WB2CBA/PEBBLE-20m-HF-TRANSCEIVER/PEBBLEHF V2.7 40m BAND/PEBBLEHF V2.7 40m SOLDER SIDE LAYOUT.jpg

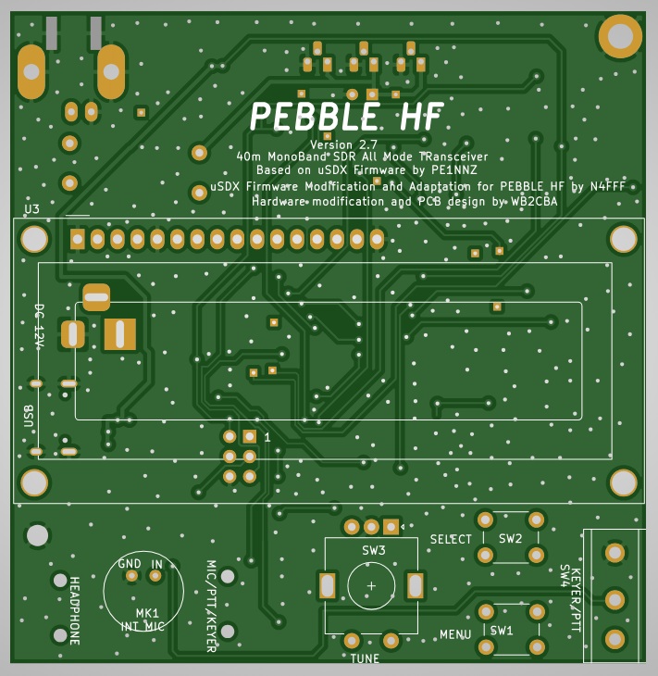
PEBBLEHF V2.7 40m BAND/PEBBLEHF V2.7 40m SOLDER SIDE LAYOUT.jpg
