WB2CBA/PEBBLE-20m-HF-TRANSCEIVER/README.md

# PEBBLE-HF-MONOBAND SDR HF TRANSCEIVER

https://pebblehf.com/
---------------------

PEBBLE HF is an open source project. Hardware details are in this github. I also included latest firmware under PEBBLEHF FIRMWARE directory for the sake of practical reaching to the latest version.

PEBBLE HF info and build manual plus Latest PEBBLE HF Firmware can be downloaded from this github link: https://github.com/mspiceland/usdx-pebblehf
-------------------------------------------------------------------------------------------------------------------------------------------
PEBBLE HF is a Monoband HF ALL MODE SDR TRANSCEIVER. Currently there is two band versions, 20m band and 40m band you can build with all the files and info posted in this github page.
-------------------------------------------------------
Pebble HF

Richard Hinsley/ VK2ARH put together a very detailed PEBBLEHF Build Manual for 40m PEBBLEHF. It can also be used for 20m PEBBLEHF Build as they are identical apart from operating frequencies. I added to this repository. 

Thank you Richard. This is a great help.

Mike, N4FFF designed a very nice 3D printed case for PEBBLEHF. Here is the link: https://hamradioduo.com/print-your-own-pebble-hf-case/

For anyone who is 3D print challenged like myself I put together a bolt on top and bottom PCB panels which are included as GERBER files in the fabrication 
files folders. It is not as elegant as 3D case but does the job to cover and protect the electronics. This cover is compatible with both V2.5 and V2.7 Pebblehf.



PEBBLE HF is based on USDX Micro Software Defined Transceiver Project with hardware and Firmware changes adapted to suit PEBBLE HF functions.

uSDX: micro Software Defined Transceiver Project Github Link.
https://github.com/threeme3/usdx

Anyone can build PEBBLE HF and program it with uSDX firmware or PEBBLE HF Specific Firmware. PEBBLE HF Hardware works with both options.

PEBBLE HF Transceiver can be ordered from www.jlcpcb.com using fabrication files in fabrication file folder.

Credits
-------
Pebble HF Project: Mike N4FFF - Firmware modifications and project maintenance

Original uSDX Project: The uSDX was originally announced in the QRPLabs Forum as a SSB modification for a QCX. The uSDX transmitter and receiver stage both running on a ATMEGA328P, including its multiband front-end and direct PA biasing/envelope-generation technique; its concept, circuit, code are a design by Guido (PE1NNZ); the software-based SSB transmit stage is a derivate of earlier experiments with a digital SSB generation technique on a Raspberry Pi.

Hardware Design: Barbaros Asuroglu (WB2CBA) - Pebble HF hardware design

Many thanks to all contributors to the open source uSDX project, without whose work the Pebble HF would not be possible.
