WB2CBA/PEBBLE-20m-HF-TRANSCEIVER/PEBBLEHF FIRMWARE/README.pdf

BOTH V1.08 firmware is same in functionality as V1.07 OFFICIAL PEBBLEHF FIRMWARE POSTED ON THIS LINK:
https://github.com/mspiceland/usdx-pebblehf
The only change in V1.08 firmware is the ability to select board band type before flashing the firmware.
There is no need to upgrade to V1.08 Firmware if you already have a V1.07 firmware installed on your PEBBLEHF.
