WB2CBA/PEBBLE-20m-HF-TRANSCEIVER/IMG_0782.jpeg

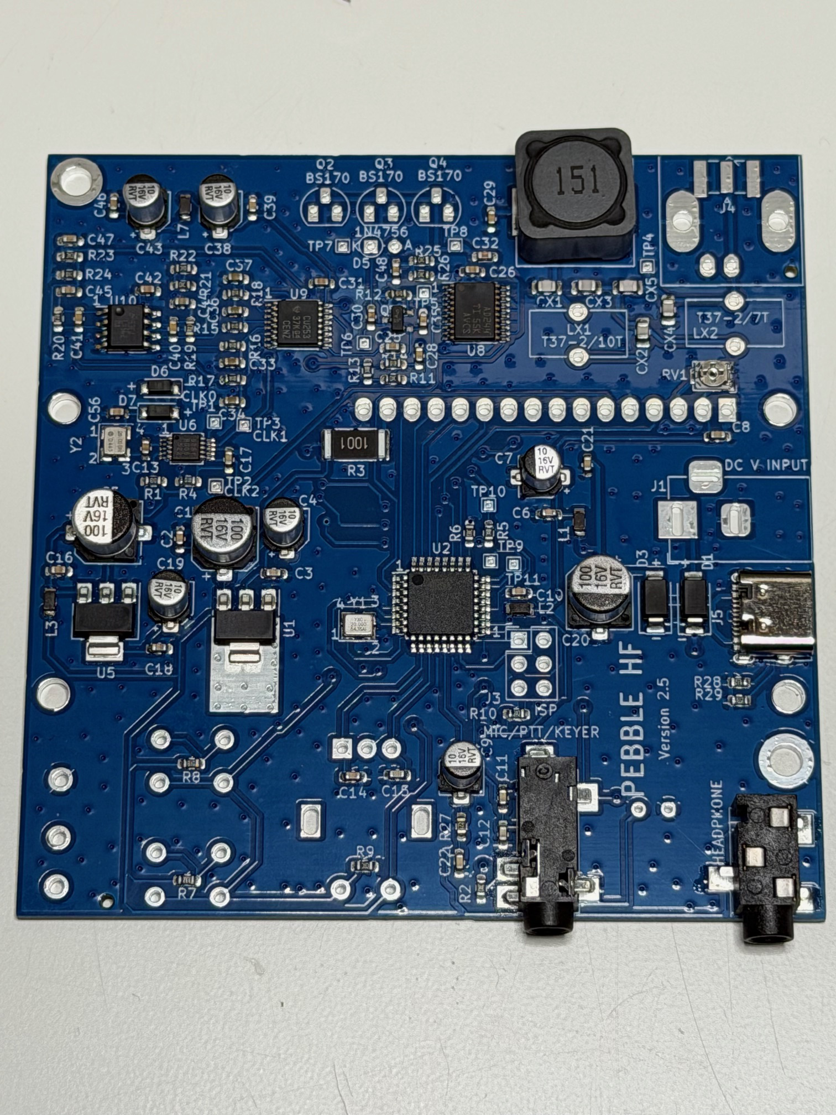
IMG_0782.jpeg
