WB2CBA/PEBBLE-20m-HF-TRANSCEIVER/IMG_0795.jpeg

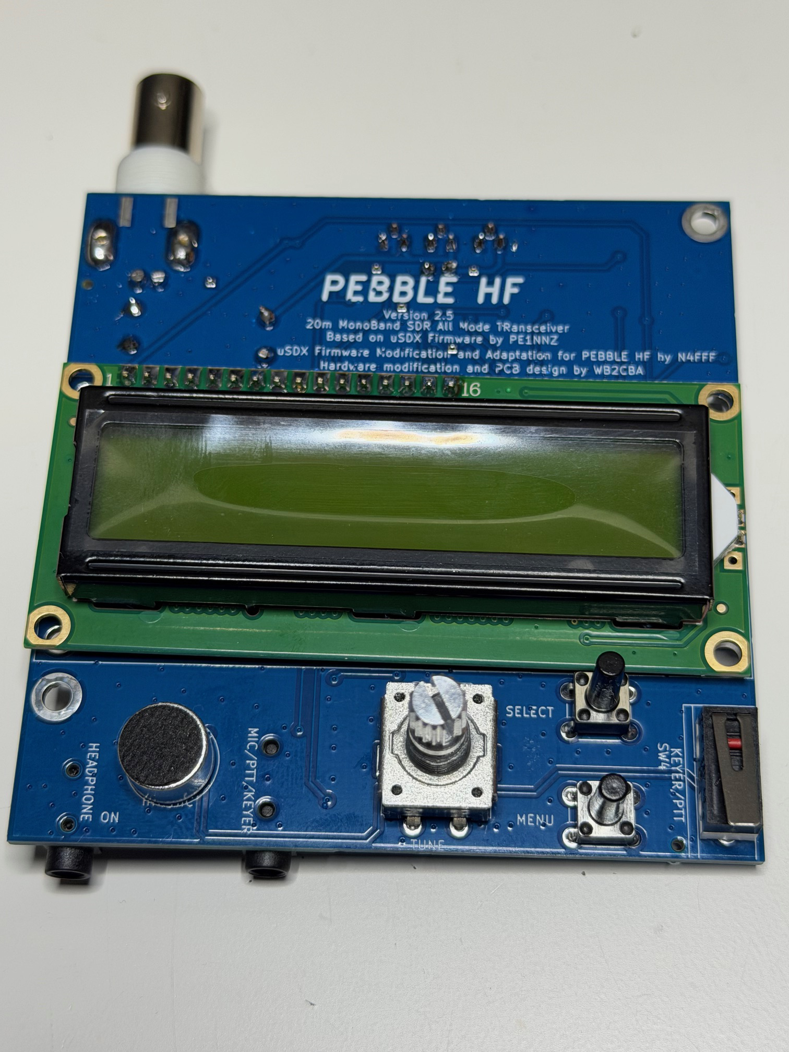
IMG_0795.jpeg
