WB2CBA/PEBBLE-20m-HF-TRANSCEIVER/IMG_0796.jpeg

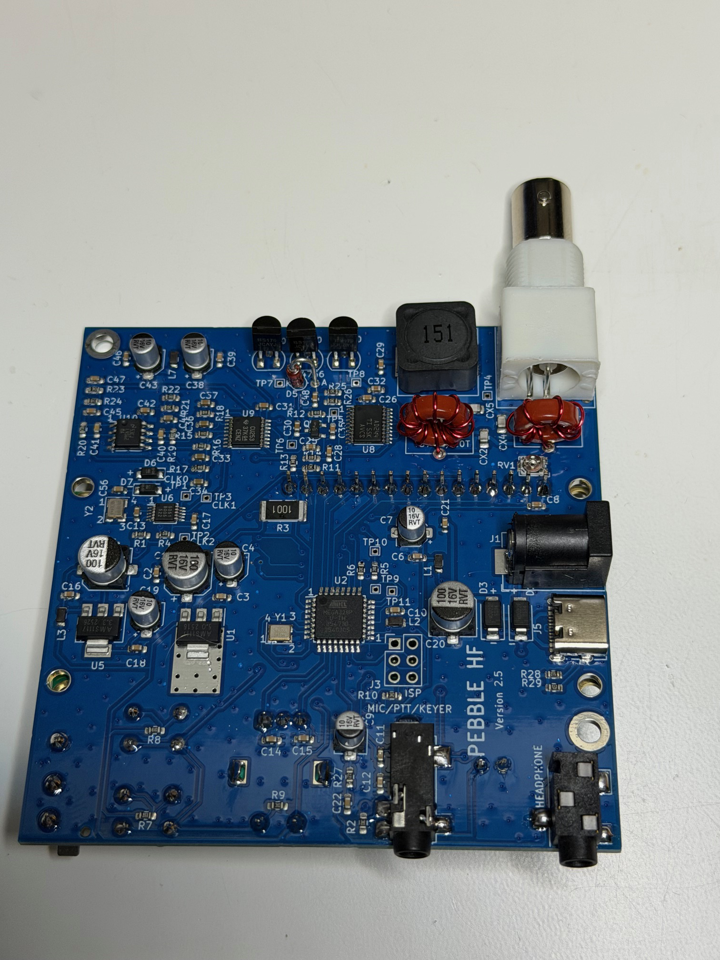
IMG_0796.jpeg
