WB2CBA/PEBBLE-20m-HF-TRANSCEIVER/PEBBLE HF MIC_PTT_KEY and HEADPHONE JACK PIN LAYOUT.jpg

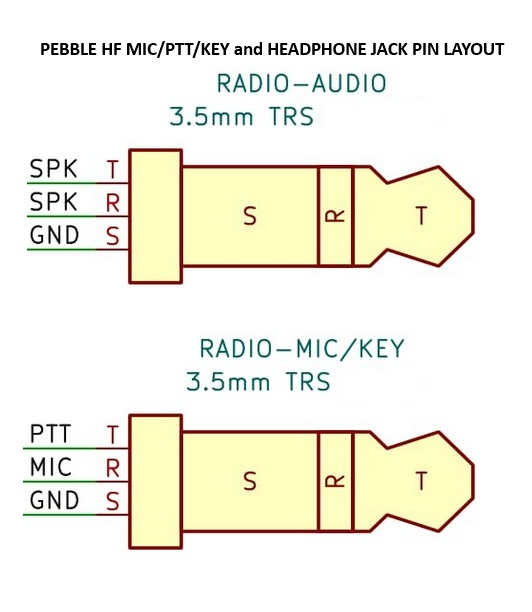
PEBBLE HF MIC_PTT_KEY and HEADPHONE JACK PIN LAYOUT.jpg
