WB2CBA/PEBBLE-20m-HF-TRANSCEIVER/PEBBLEHF V2.7 40m BAND/PEBBLEHF BOTTOM PCB COVER.jpg

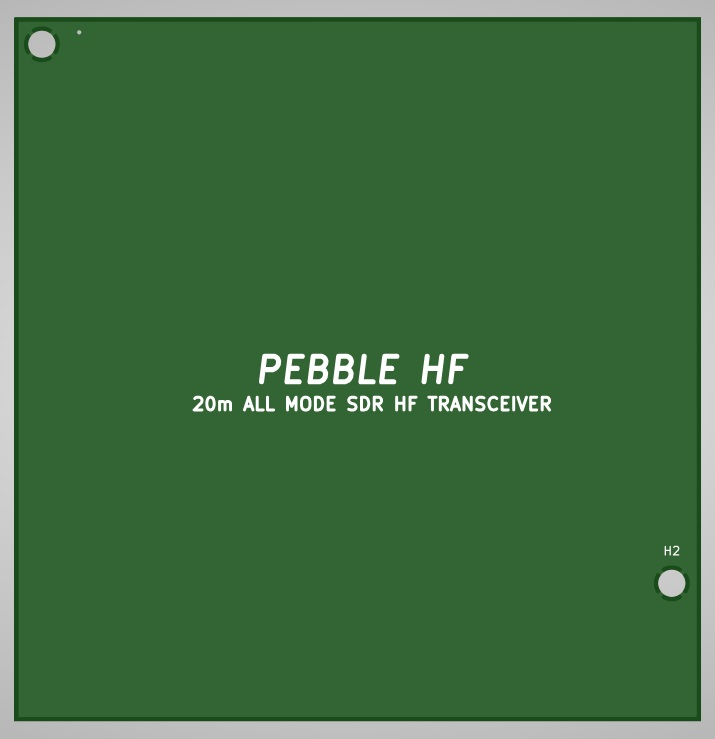
PEBBLEHF V2.7 40m BAND/PEBBLEHF BOTTOM PCB COVER.jpg
