WB2CBA/PEBBLE-20m-HF-TRANSCEIVER/PEBBLEHF V2.7 40m BAND/BOM PEBBLE HF THROUGH HOLE PARTS.pdf

PEBBLE HF THROUGH HOLE PARTS
| PART | Item Nr. | Similar Part Link
1 | 2X16 LCD DISPLAY | 1 | https://a.co/d/0aVVxPoo
2 | BNC PCB TYPE CONNECTOR | 1 | https://a.co/d/03Xsk6dZ
3 | 6x6x12mm Tactile pushbutton Switch | 2 | https://a.co/d/02NX1fg8
4 | Rotary Encoder | 1 | https://a.co/d/0b1exBpE
5 | T37-2 TOROID | 2 | https://toroids.info/T37-2.php
6 | AWG24/0.35 mm Magnet wire - 3 ft/1m | 1 | https://a.co/d/0gwRWuff
7 | BS170 MOSFET TRANSISTOR | 3 | https://www.mouser.com/ProductDetail/o
nsemi/BS170?qs=FOlmdCx%252BAA0Q%2 52B3zvwxJUKQ%3D%3D
8 | Micro Switch | 1 | https://a.co/d/07sd14Mg
9 | Electret Microphone | 1 | https://a.co/d/0f66Y2du
10 | 5.5mmx2.1mm DC Barrel Connector | 1 | https://a.co/d/0bSa3gcI
11 | 2x16 pin 2.54 mm Male Header | 1 | https://a.co/d/0cRdQyMj
11 | 1N4756 ZENER DIODE | 1 | https://www.digikey.com/en/products/det
ail/onsemi/1N4756A/977325?gclsrc=aw.ds &gad_source=1&gad_campaignid=202283 87720&gclid=CjwKCAjww-3VBhAcEiwAwUUIu6tgWqL5qTlrRtG0t4U7r kWxjsEKFFDMop6WJSLK4PFlGHgChwmN_x oC0T8QAvD_BwE
