WB2CBA/PEBBLE-20m-HF-TRANSCEIVER/PEBBLEHF RF PERFORMANCE MEASUREMENT DATA/1000012073.png

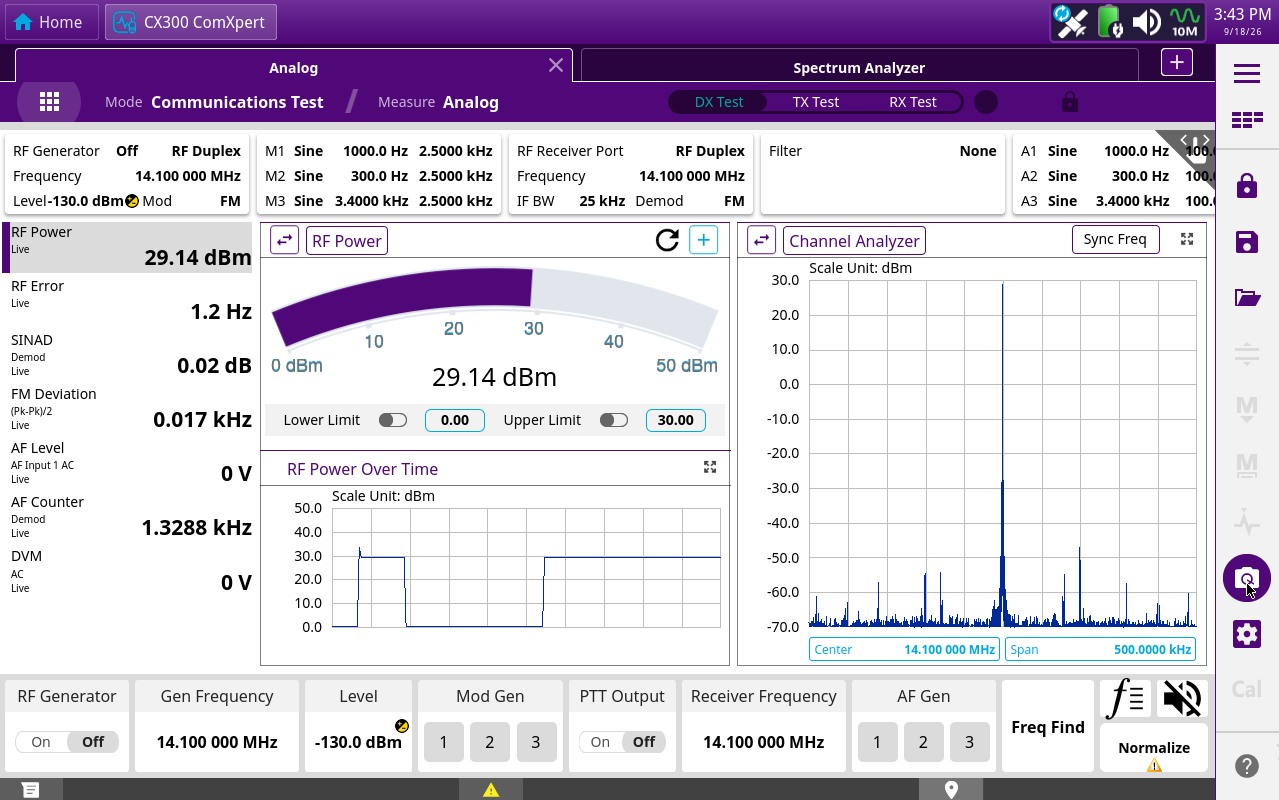
PEBBLEHF RF PERFORMANCE MEASUREMENT DATA/1000012073.png
