WB2CBA/PEBBLE-20m-HF-TRANSCEIVER/PEBBLEHF RF PERFORMANCE MEASUREMENT DATA/PEBBLE HF TX Harmonic Measurement (1).png

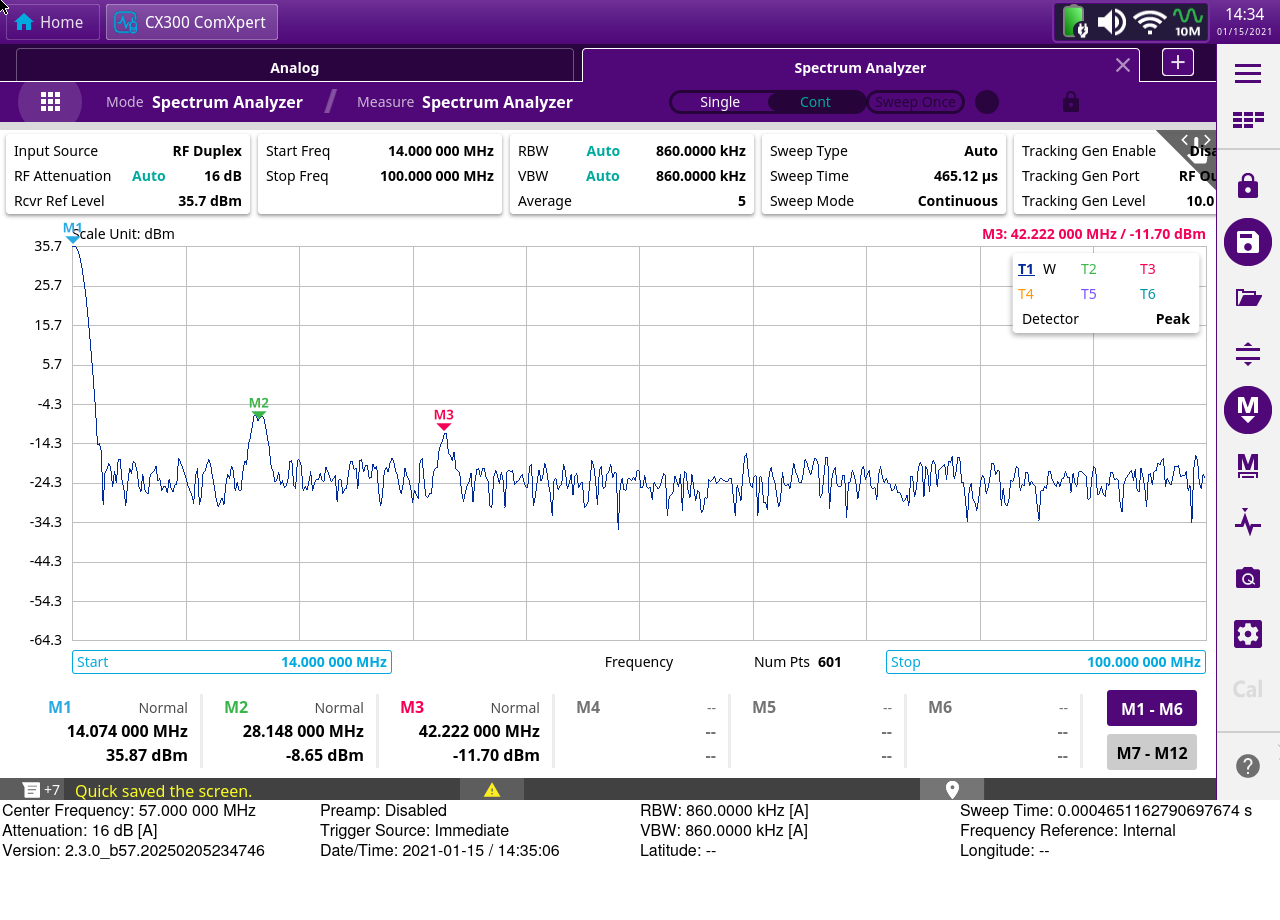
PEBBLEHF RF PERFORMANCE MEASUREMENT DATA/PEBBLE HF TX Harmonic Measurement (1).png
