WB2CBA/PEBBLE-20m-HF-TRANSCEIVER/PEBBLEHF RF PERFORMANCE MEASUREMENT DATA/pebble_rx sinad Measurement(1).png

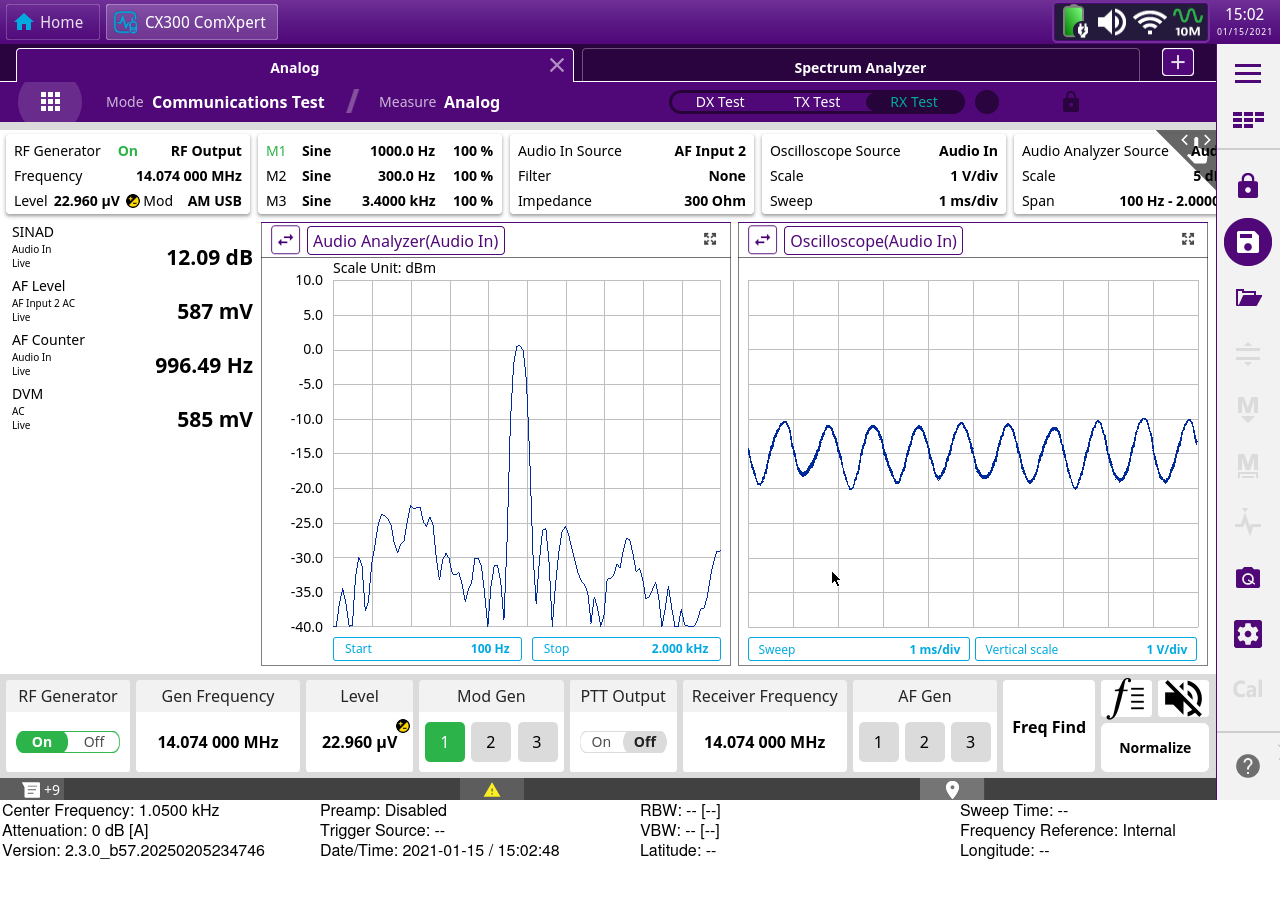
PEBBLEHF RF PERFORMANCE MEASUREMENT DATA/pebble_rx sinad Measurement(1).png
