WB2CBA/PEBBLE-20m-HF-TRANSCEIVER/PEBBLE HF V2.5 SCHEMATIC.pdf

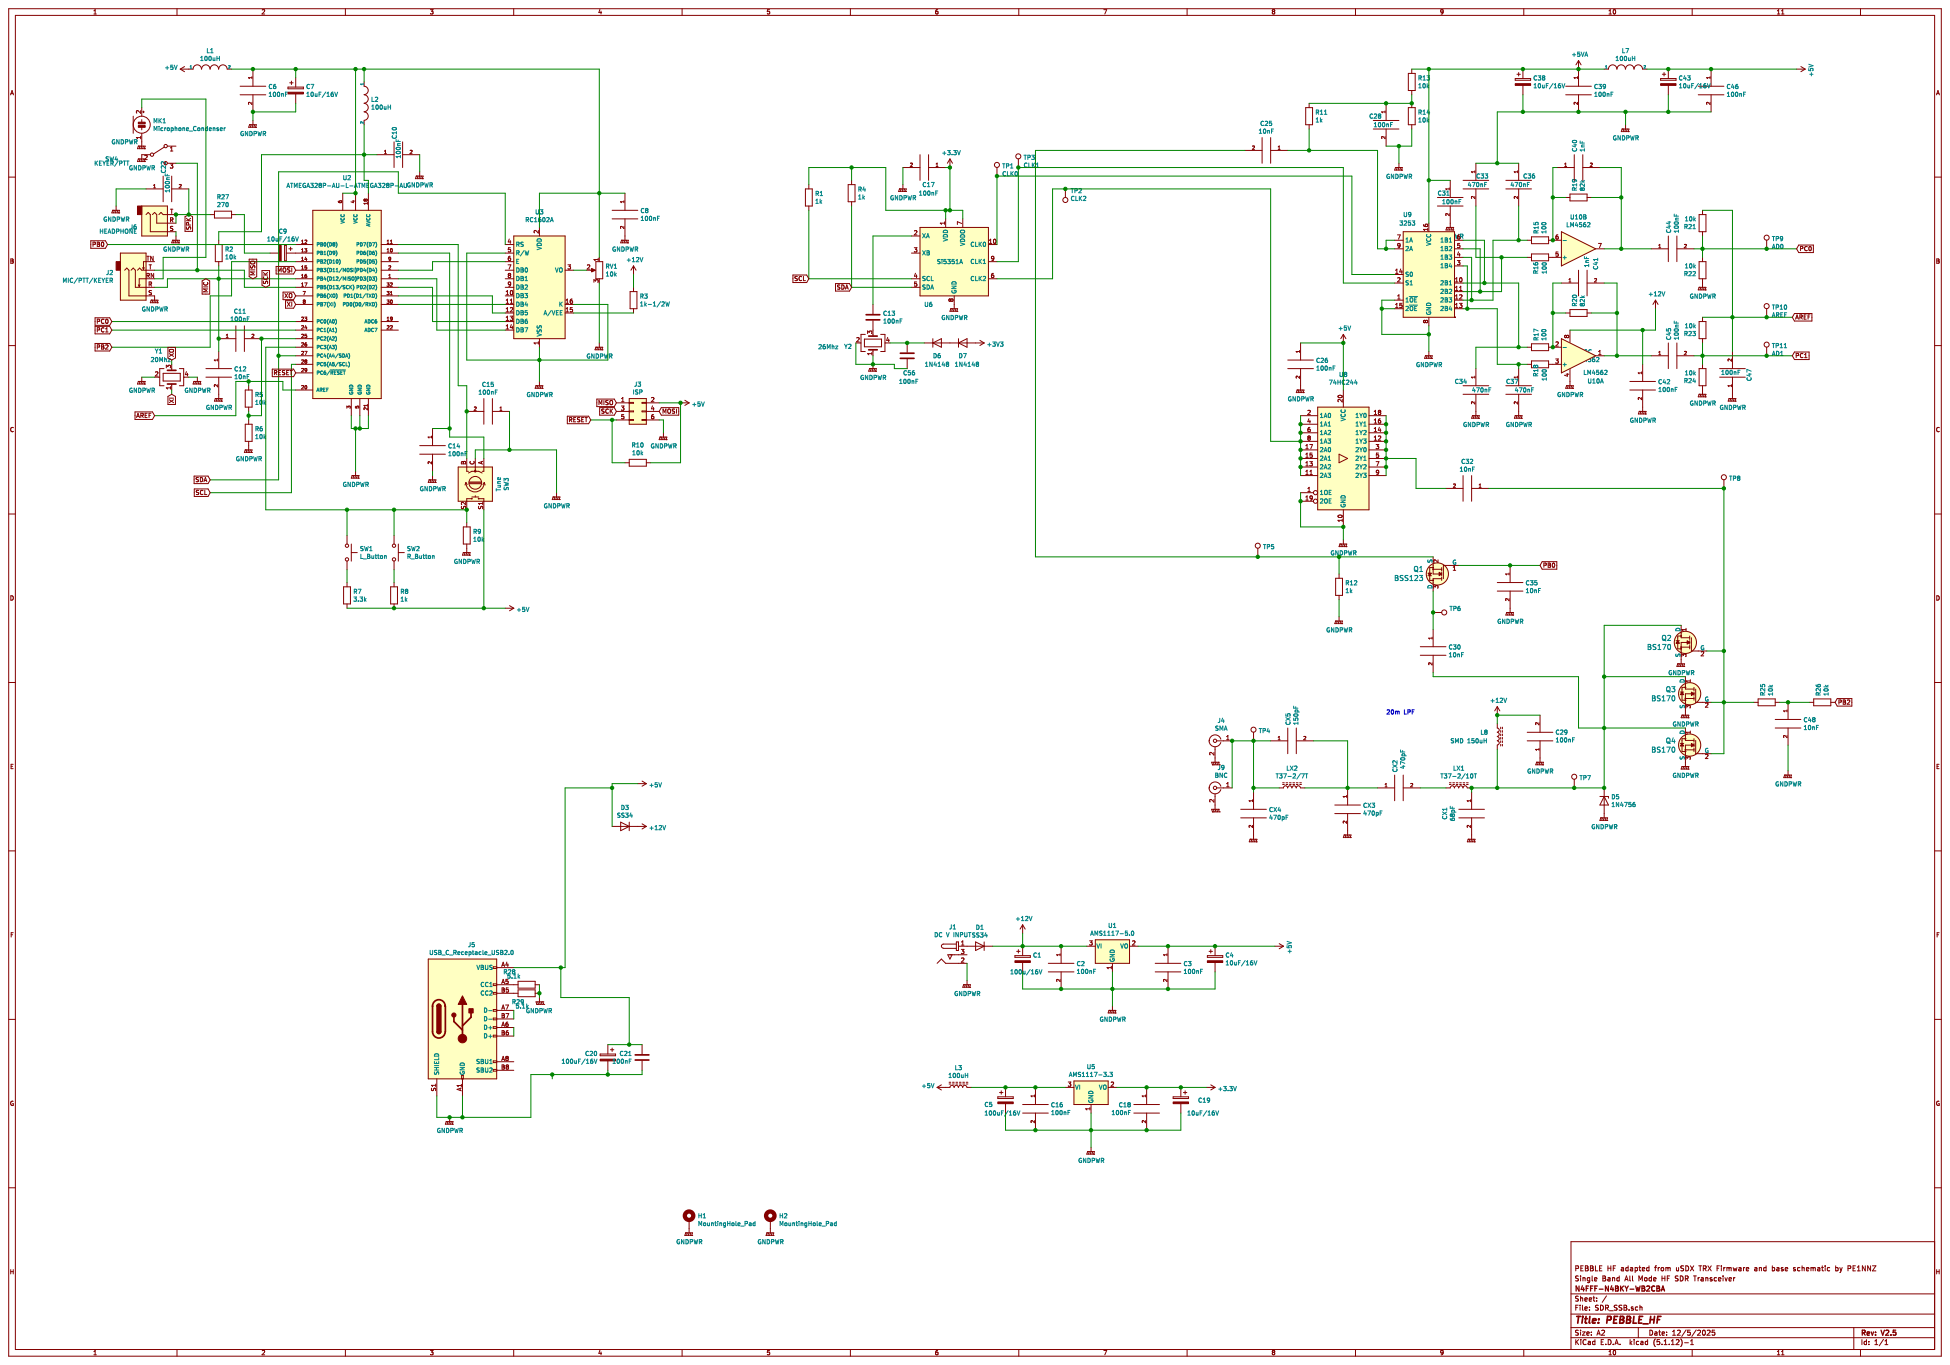
[picture p57: page 1]
