WB2CBA/PEBBLE-20m-HF-TRANSCEIVER/PEBBLEHF V2.7 40m BAND/PEBBLEHF V2.7 40m SCHEMATIC.pdf

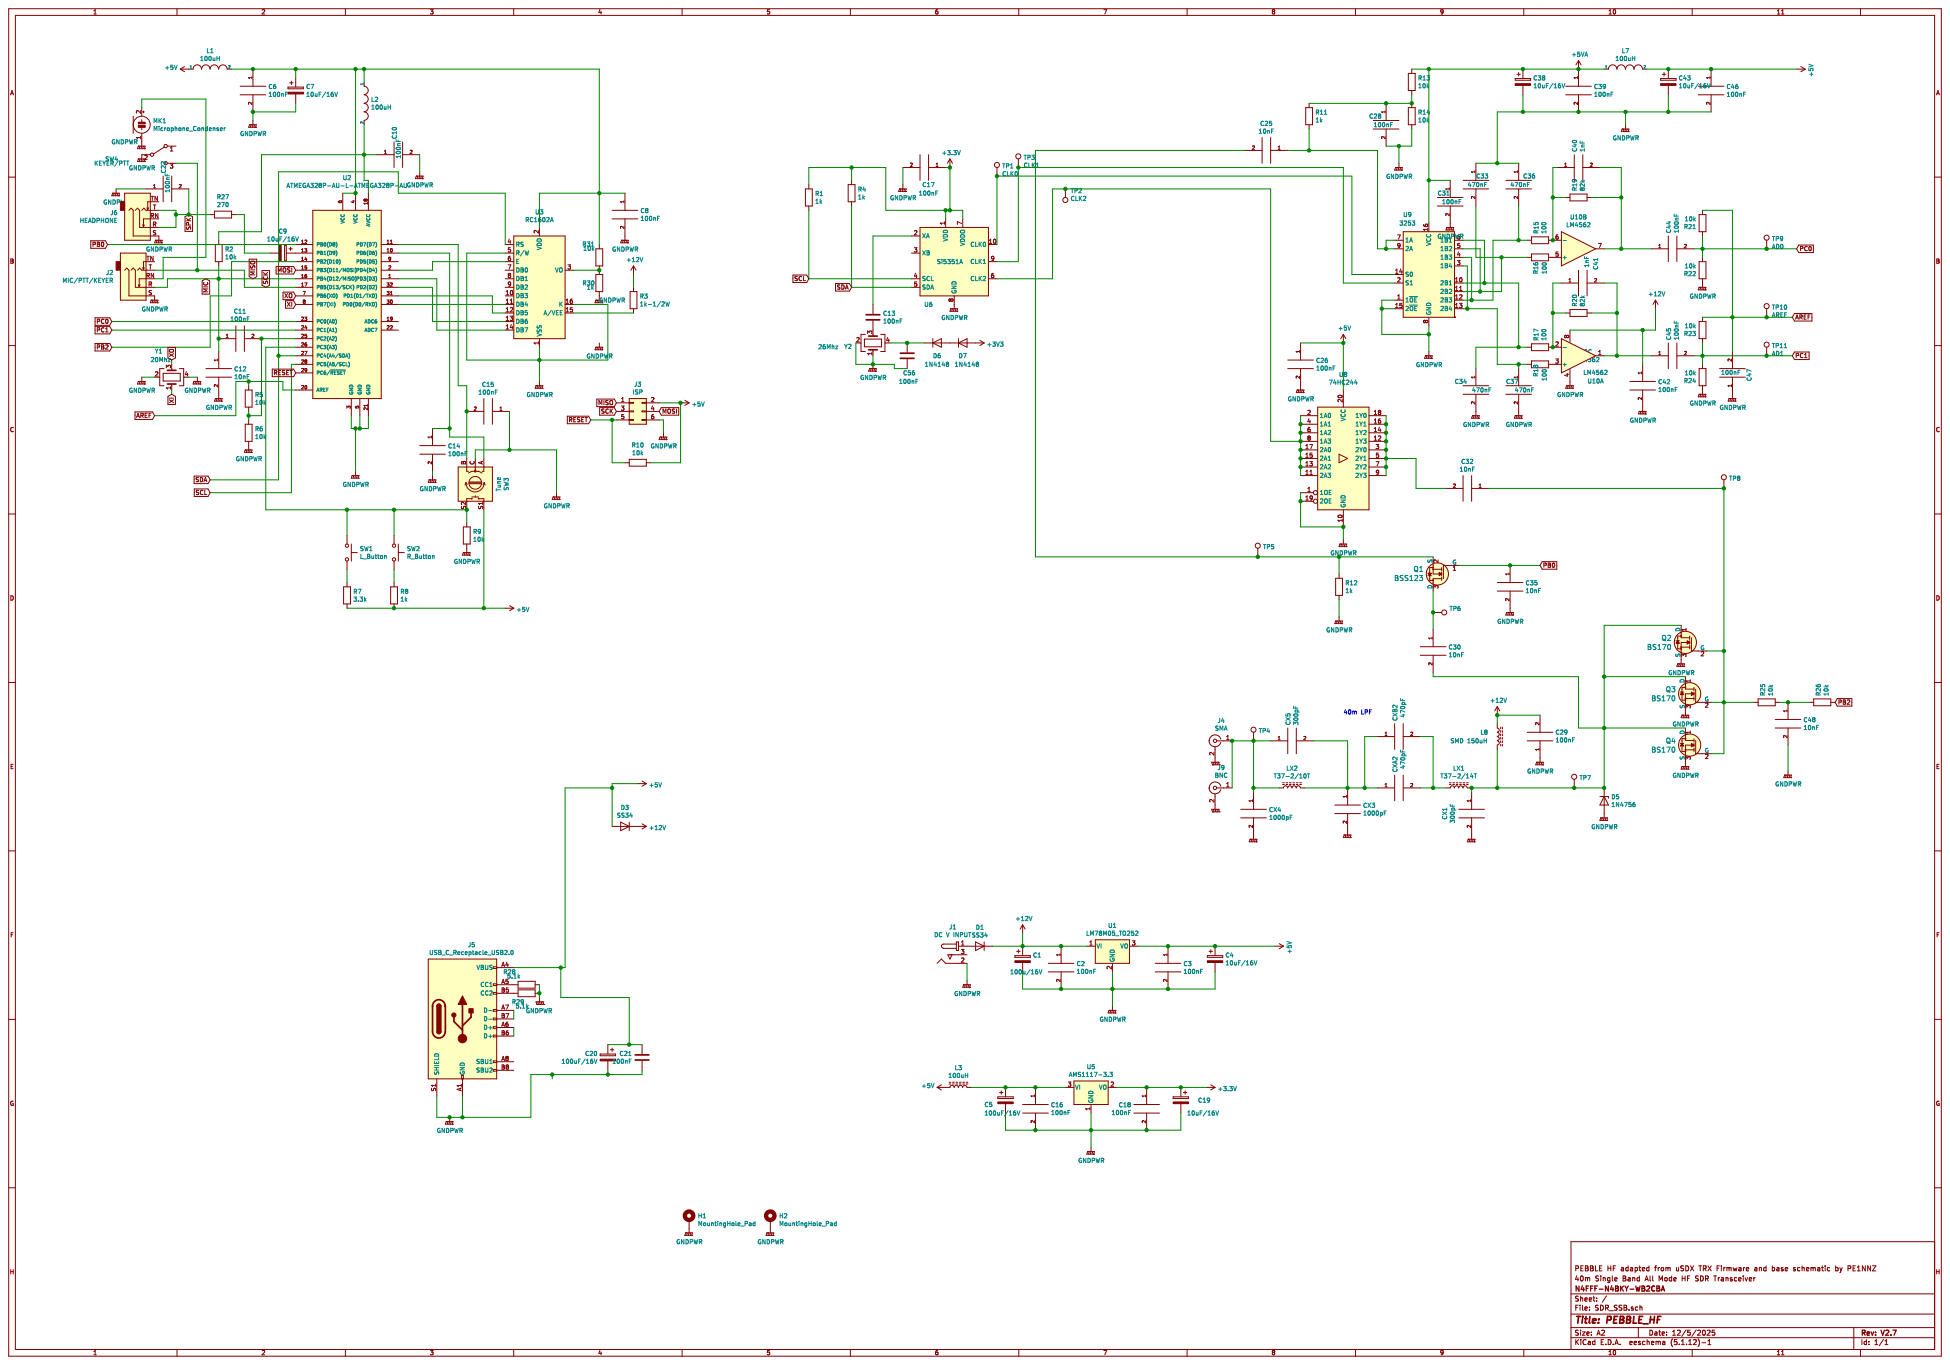
[picture p58: page 1]
