WB2CBA/PEBBLE-20m-HF-TRANSCEIVER/PEBBLEHF V2.7 20m Band/PEBBLEHF V2.7 20m SCHEMATIC.pdf

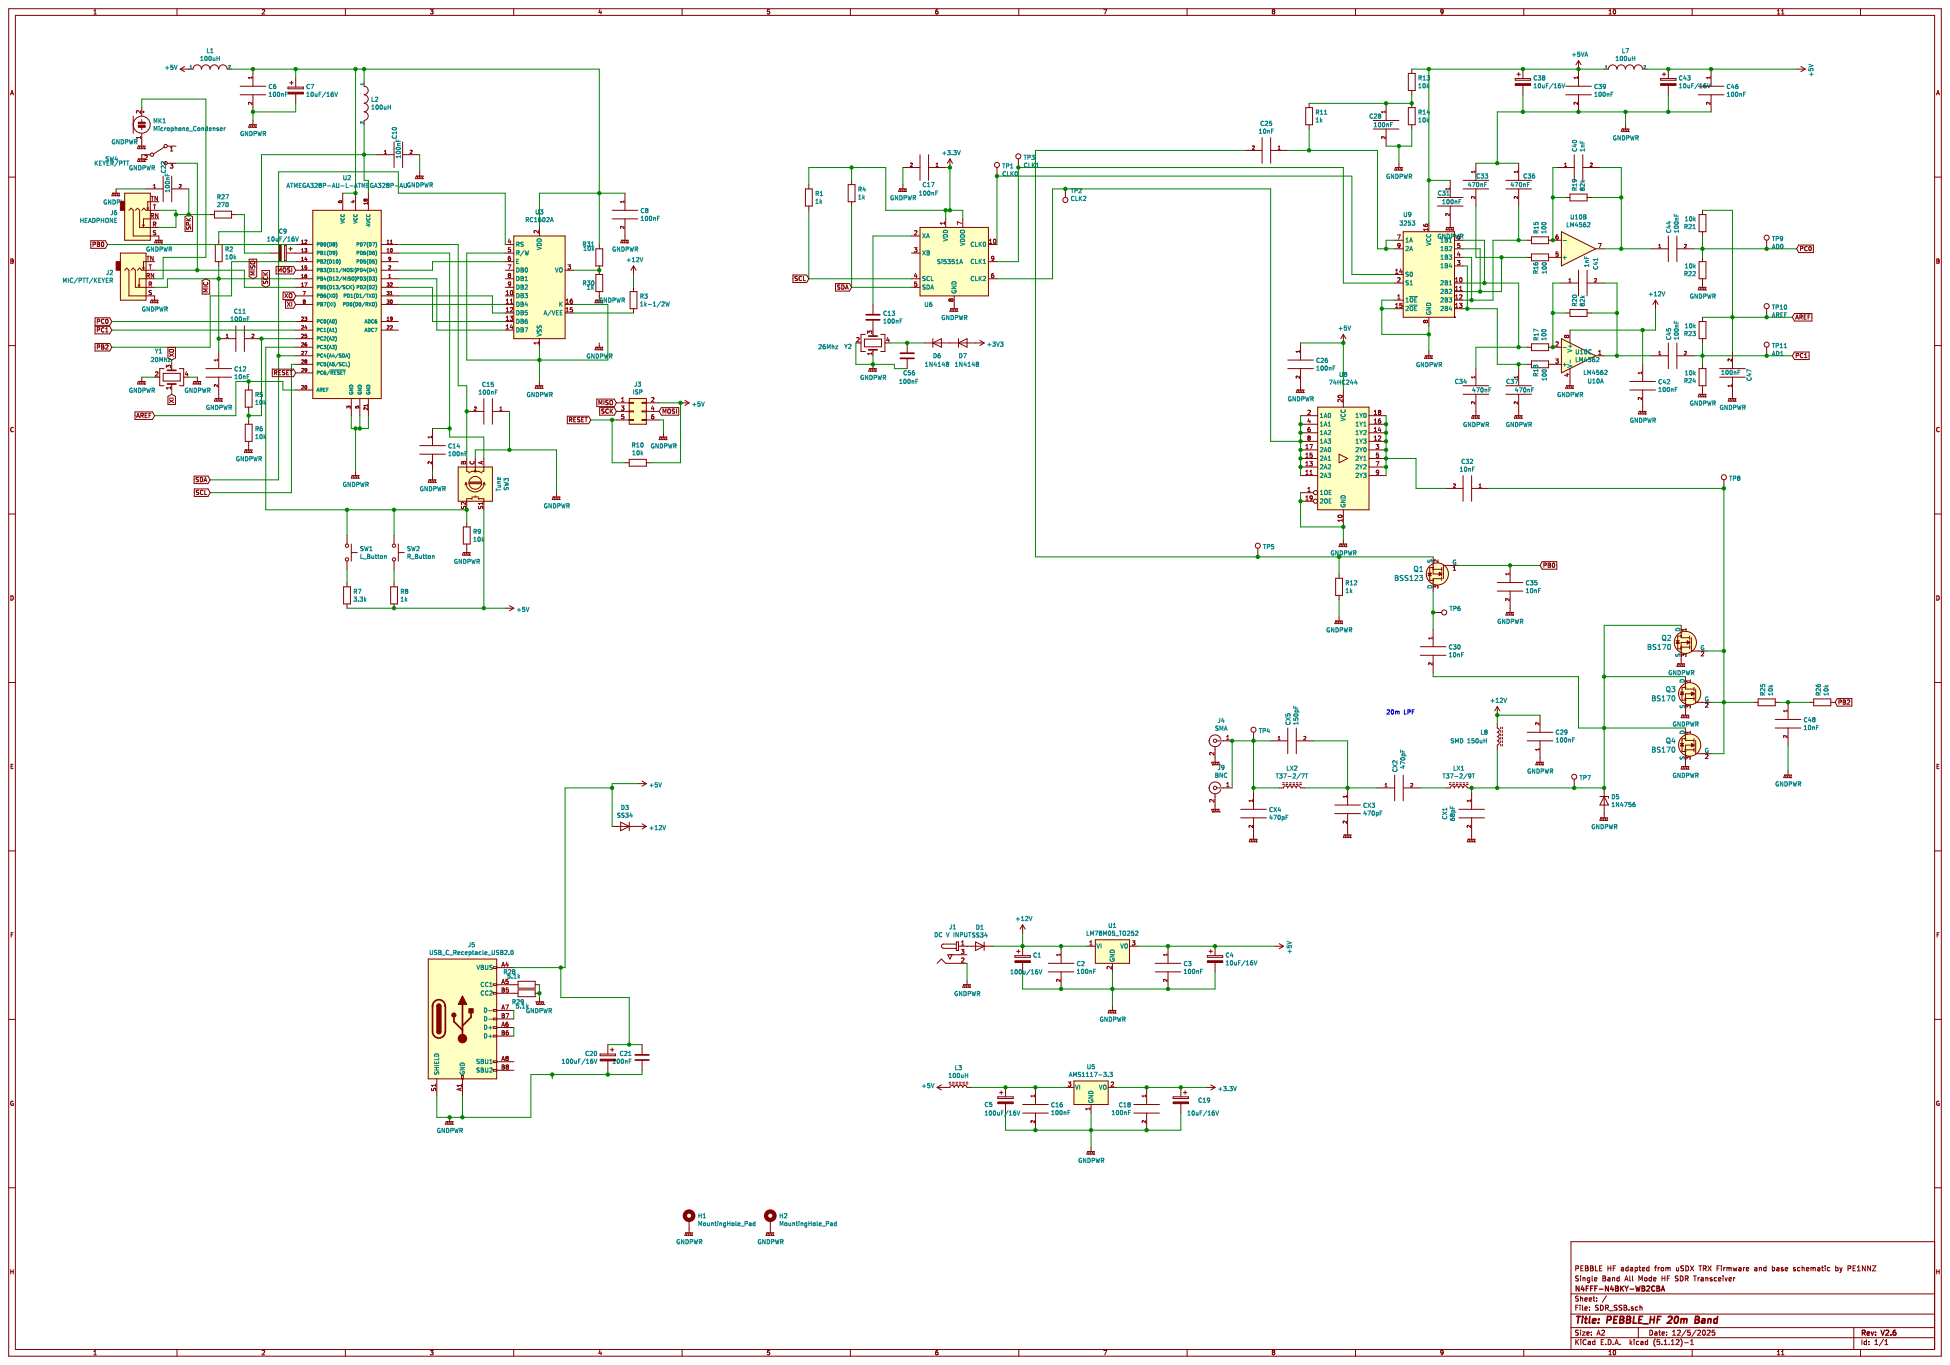
[picture p59: page 1]
